AlexMacQuarrie/yachtonomous/README.md

# yachtonomous
Autonomous Sailboat Project

Yachtonomous is an Autonomous Sailboat project created for ELEC 490 Capstone Project, 2024-2025

Authors (Group 32):
- Alex MacQuarrie
- Liam Herbert
- Yasin Shahrami

Faculty Supervisor:
- Dr. Sean Whitehall

## Structure
- boat - Boat model (3D models)
- hardware - Electronics (PCBs)
- src - Source code for the boat (Python, MicroPython, C++)
- sim - Simulation code for the boat (Python)
- docs - Project documentation (Text files for mermaid charts)
- firmware - Raspberry Pi Pico W Firmware (MicroPython & ulab)
