AlexMacQuarrie/yachtonomous/hardware/README.md

# Hardware
This directory stores electronics-related files like PCB and circuit files
