AlexMacQuarrie/yachtonomous/firmware/README.md

# Firmware
This directory stores the .uf2 firmware for the Pico W
