AlexMacQuarrie/yachtonomous/poster.pdf

#32

Group Number

# Yachtonomous – An Autonomous Sailboat

Group Members: Liam Herbert, Alex MacQuarrie. Yasin Shahrami

PERFORMANCE & RESULTS
Individual | testing | was | completed | for | each
subsystem before integration. All PCBs are fully functional and fit in the boat. After calibration, the sensors and actuators were tested and proved to be reasonably accurate. The software was fast enough to complete a control loop iteration in 30 milliseconds.

An inflatable test pool was used to test the boat’s sailing ability in a variety of wind directions, with Bluetooth range sensors attached to the sides.

The boat struggled to sail in a straight line in most wind directions, but had some success sailing on beam reaches and broad reaches. The boat did not float as well as anticipated due to the weight of electronics, so external floatation was added.

CONCLUSIONS & RECOMMENDATIONS Overall, the design and functionality of the boat was reasonably successful. While the boat struggled to sail in some directions, it was able to sail to the destination in others, demonstrating the overall feasibility of autonomous sailboats.

The main challenge was making a boat and sail that were aerodynamically functional. The boat could be further improved by modelling the boat’s dynamics better, improving the boat and sail’s aerodynamics, using servos with rotational encoders, and using I2C for the rotation sensors instead of PWM.

ACKNOWLEDGEMENTS
We would like to thank the following people for their assistance and support in helping us undertake this project:
- Dr. Sean Whitehall, for his support in supervising the project
- Dr. Joshua Marshall, for his teaching and resources provided in ELEC 446 - Mobile Robotics
- Vince Lentini, for this support and guidance in 3D printing the boat and soldering PCBs

REFERENCES

[1] R. Wintour, "Replacing container ships with sailing boats: the future of cargo shipping?" The Guardian, Jul. 14, 2022. [Online]. Available: https://www.theguardian.com/world/2022/jul/14/replacing-container-ships-with-sailingboats-cargo-shipping-wind-power.
[2] L. Eale, "Livo 3," Thingiverse, 2015. [Online]. Available: https://www.thingiverse.com/thing:918471.
[3] Seeed Technology Co., Ltd., "Getting Started with Seeed Studio XIAO ESP32C3“, Aug. 4, 2022. [Online]. Available: https://fcc.report/FCC-ID/z4t-xiaoesp32c3/6038995.pdf.
[4] J. A. Marshall, Fundamentals of Autonomous Ground Vehicle Navigation & Control with Examples in Python, v0.5.5. Kingston, Ontario, Canada, Oct. 11, 2024.

INTRODUCTION
Sailboats provide an environmentally-friendly and
energy | efficient | alternative | for | aquatic
transportation [1]. An autonomous sailboat presents a novel design challenge and provides further benefits by eliminating manual operation.

This project aims to demonstrate the feasibility of autonomous sailing vehicles on a reduced scope, focusing on the development of methods for navigation, localization, and control of autonomous sailboats, using onboard sensors and actuators, power, and wireless communications.

BOAT DESIGN
The boat uses a trimaran design to increase stability and area for electronics [2]. 3D printing reduced cost and provided more control over the design.

The mast is driven by a belt attached to a servo, and the rudders are driven by another servo attached with a linkage system. The mainsail is made of nylon and given a shape suitable to act as an air foil to provide propulsion.

ELECTRONICS
The boat uses an IMU, two rotation sensors, and
several | Bluetooth | range | sensors | with | RSSI
measurements for localization. For actuation, two servo motors control the mast and rudder motion.

PCBs house and connect the MCUs, sensors, actuators, and power management, all powered by a 3.7V lithium-ion battery. Communication is achieved using I2C, PWM, Wi-Fi, and Bluetooth to send data between sensors, actuators, and controllers [3].

SOFTWARE
The | boat’s | software | is | written | in | Python,
MicroPython, and C++. The onboard Raspberry Pi reads from sensors, sends the sensor data over Wi-Fi to a PC, which runs navigation, localization, and control algorithms, to compute actuator inputs.

The custom navigation algorithm allows the boat to sail in any wind direction, while minimizing distance and number of tacks. Localization and feedback control are implemented using an Extended Kalman Filter, and Model Predictive Control, respectively [4].

A software simulation environment was also completed to allow for testing and development, independent of the hardware.

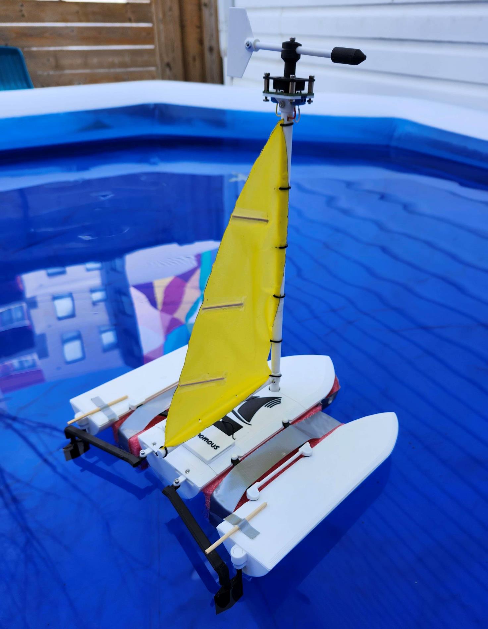
[picture p1: figure]

(1) The boat in the test environment

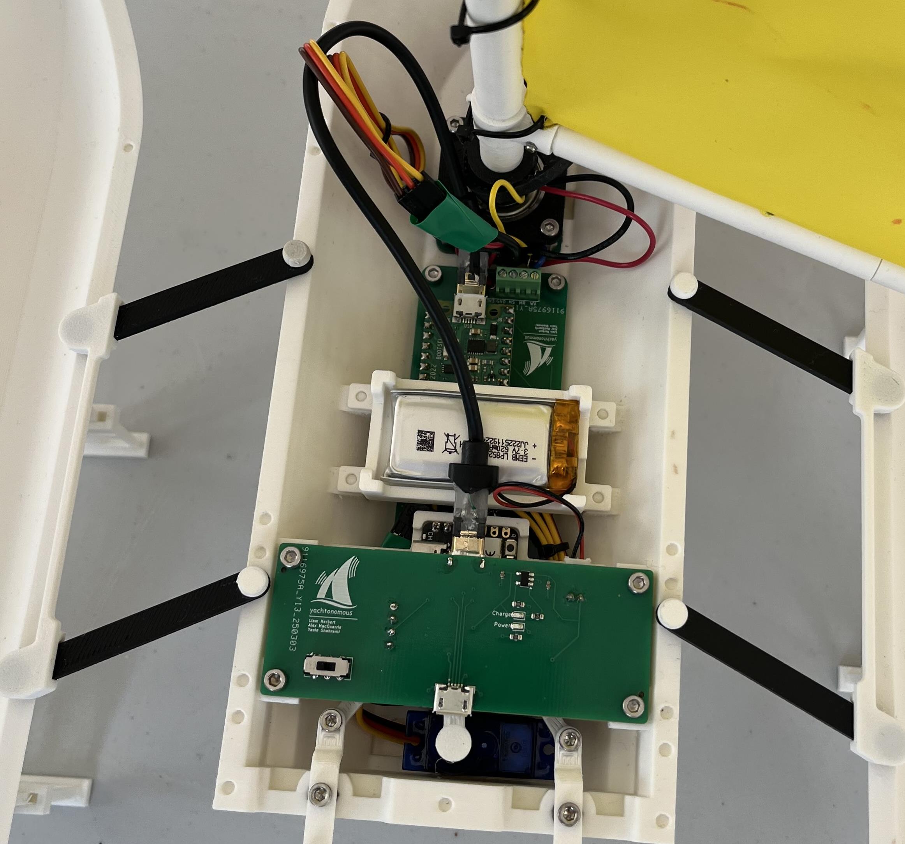
[picture p2: figure]

(2) Electronics inside the main hull

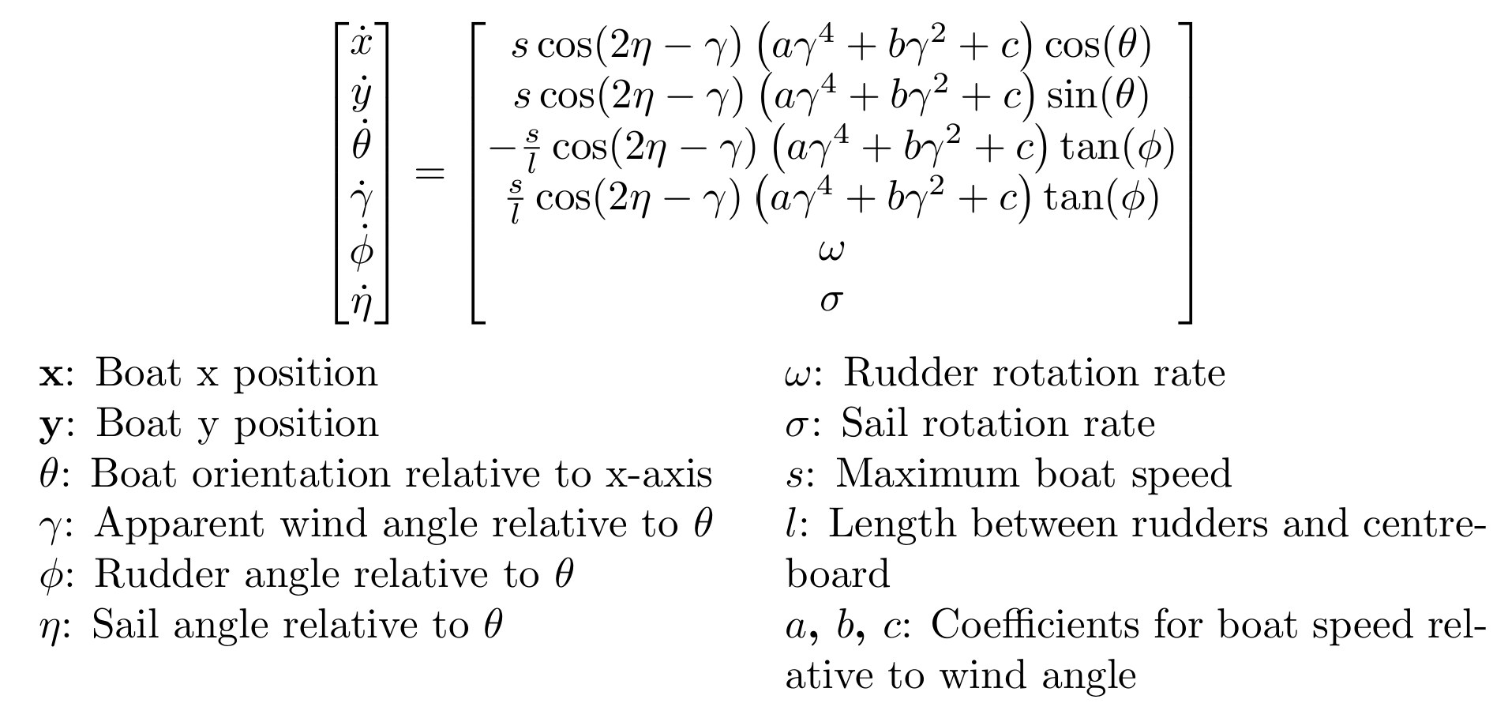
[picture p3: figure]
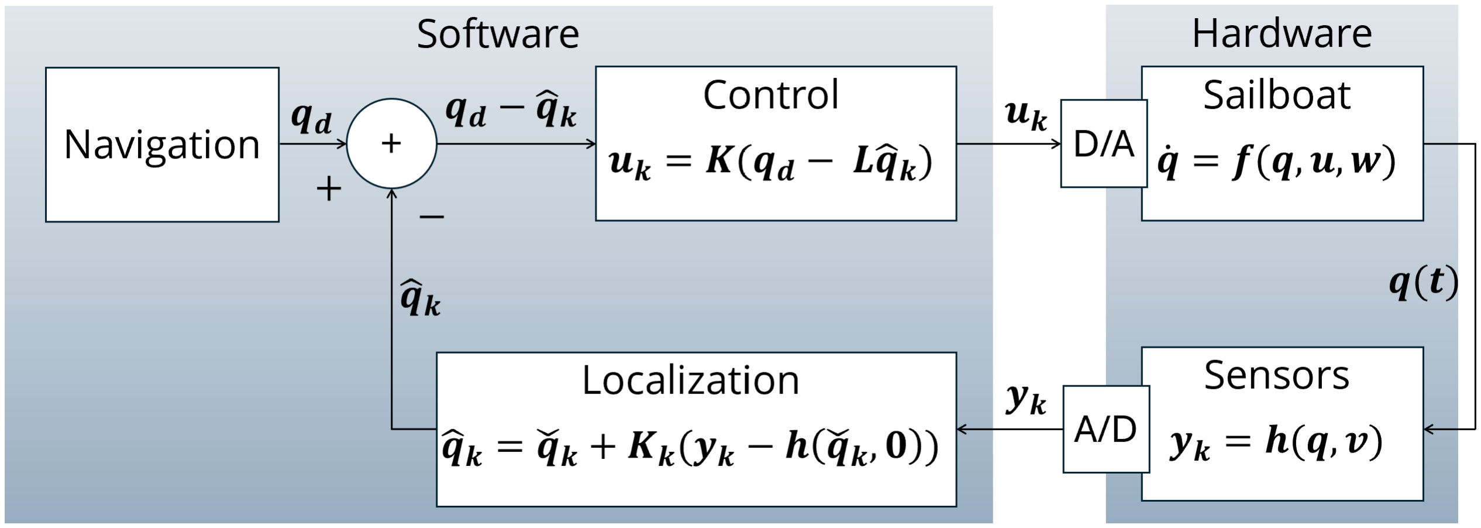
[picture p4: figure]

(3) Control block diagram | (4) Kinematic model of the boat’s motion

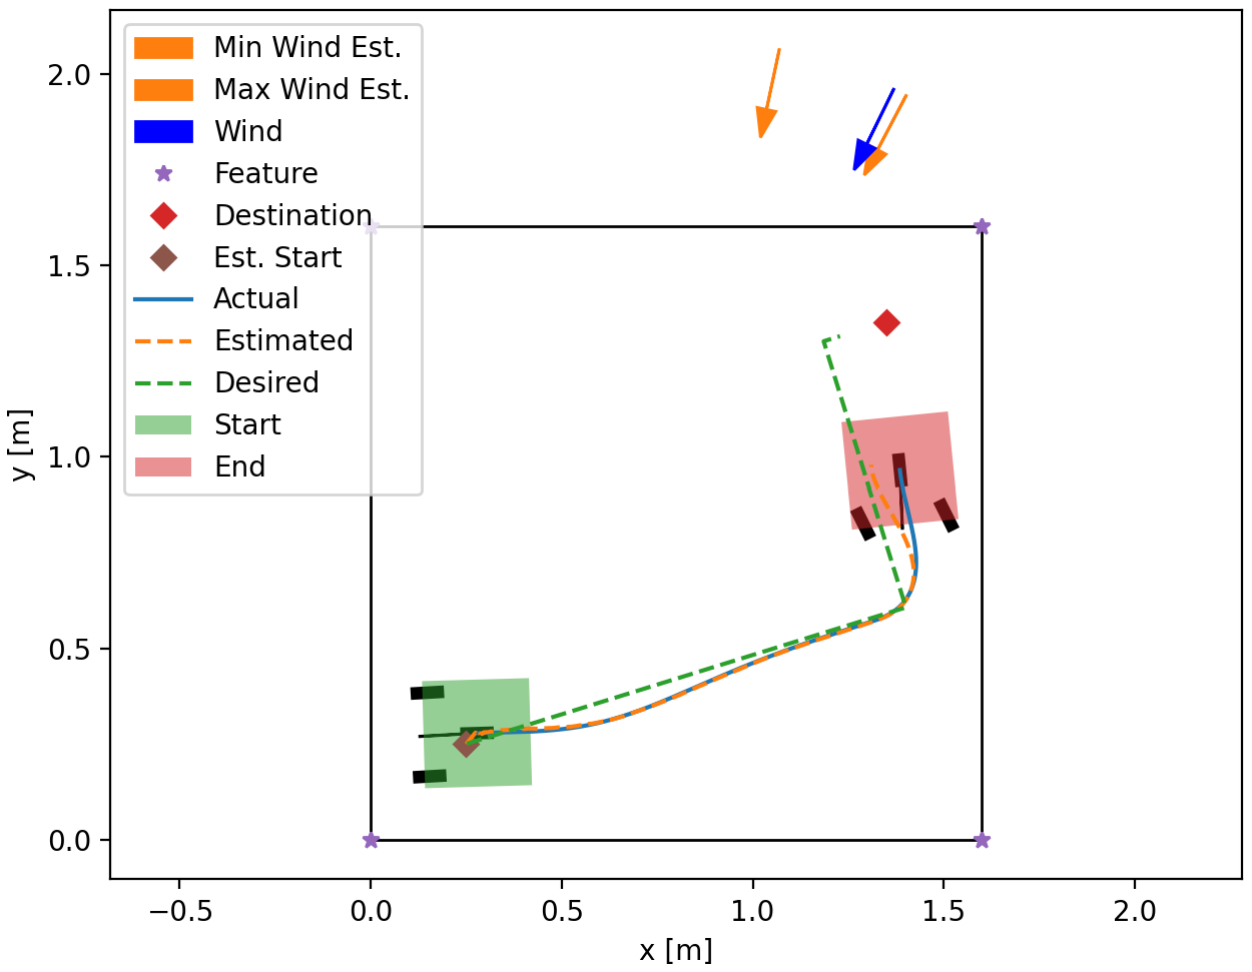
[picture p5: figure]
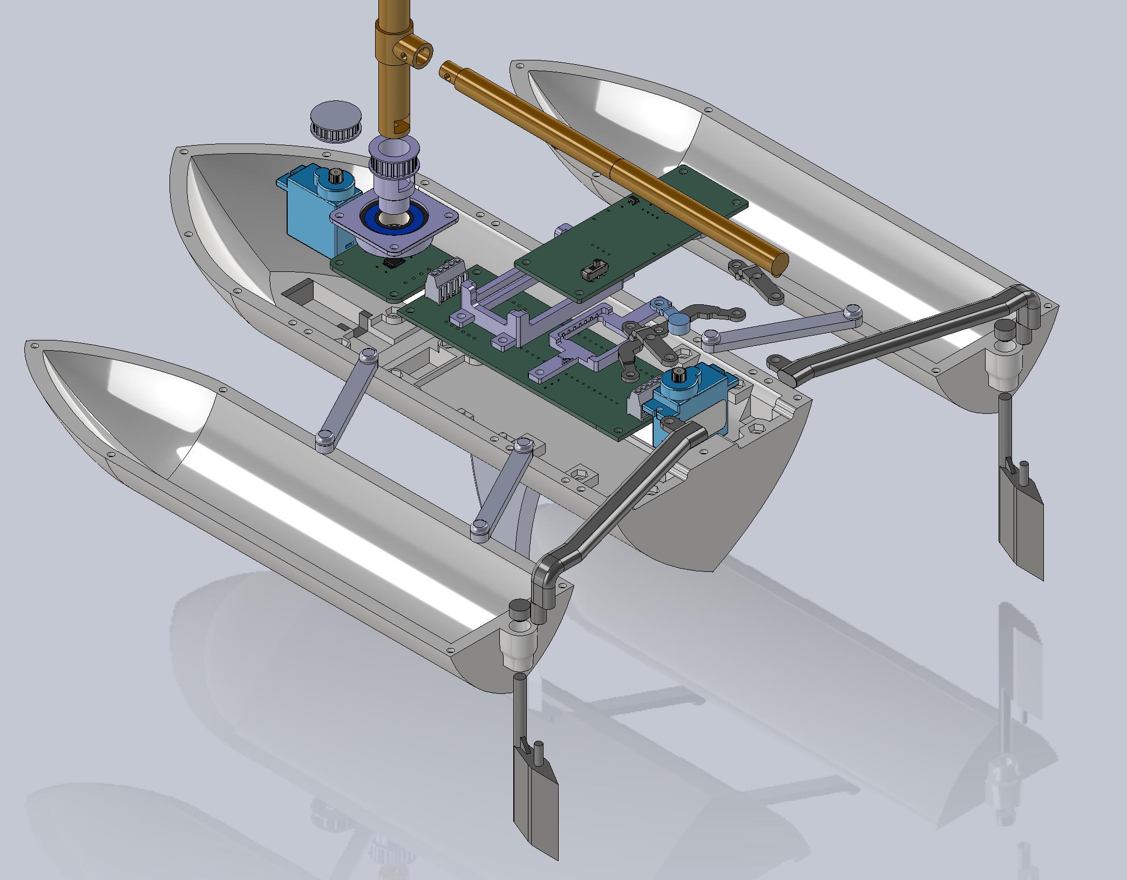
[picture p6: figure]

(5) SOLIDWORKS exploded assembly view | (6) An output from the software simulation

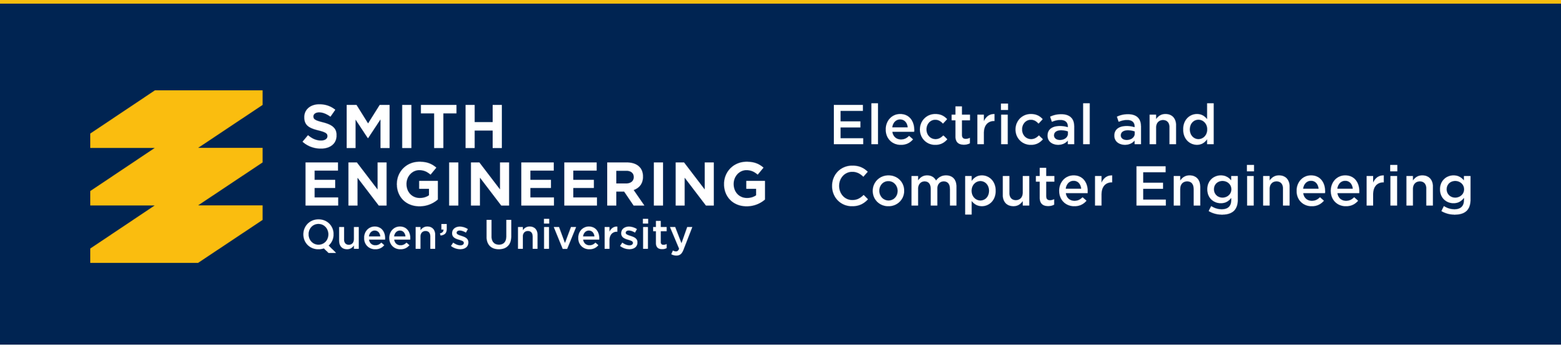
[picture p7: figure]
