AlexMacQuarrie/yachtonomous/src/results/boat_log.csv

x_x | x_y | x_t | x_g | x_p | x_e | x_d_x | x_d_y | x_d_t | x_d_g | x_d_p | x_d_e | u_e | u_p | u_a_e | u_a_p | t
0.35 | 0.35 | 0.0 | 0.5 | 0.0 | 0.0 | 0.35226819349951377 | 0.349334493897513 | -0.2853981633974483 | 0.7853981633974483 | 0.0 | 0.39269908169872414 | 0.0 | 0.0 | 0.0 | 0.0 | 0.0
238.5351666156384 | -130.85159986987676 | 0.020256670128192815 | 0.49903870224994484 | -0.005485558678632211 | 0.5011227063979126 | 0.35453638699902756 | 0.348668987795026 | -0.2853981633974483 | 0.7853981633974483 | 0.0 | 0.39269908169872414 | -0.09003264965771073 | -0.7853981633974483 | -0.0045016324828855364 | -0.039269908169872414 | 0.05
238.53715562469958 | -130.85153186418245 | 0.032993233563017074 | 0.49925580973211486 | -0.061491023765534655 | 0.4982982879787614 | 0.35680458049854136 | 0.348003481692539 | -0.2853981633974483 | 0.7853981633974483 | 0.0 | 0.39269908169872414 | -0.08768731325410199 | -0.7853981633974483 | -0.008885998145590636 | -0.07853981633974483 | 0.1
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
