AlexMacQuarrie/yachtonomous/(commit log)

2025-02-08 Added integration for imu & inputs. Sim (kinematic) should be done now
2025-02-13 Updates for switching to Wifi and computation on PC
    [boat_log.csv]
2025-02-13 Adding firmware and changing parse_csv.py a bit
    [boat_log.csv]
2025-02-14 making stuff a bit faster, still working on that
    [boat_log.csv]
2025-02-15 some more performance improvements, done for now
    [boat_log.csv]
2025-02-23 Adding some initial RSSI handling and ESP32 server/client code
2025-02-27 Adding wifi code
    [boat_log.csv]
2025-02-28 Updating ESP32 delays, needs to be tested
2025-02-28 Adding zip file for PCB files
2025-02-28 Fix ESP32 string type
    [esp32_cli_0.ino, esp32_cli_1.ino, esp32_cli_2.ino, esp32_cli_3.ino]
2025-03-01 adding initial driver files
2025-03-01 updating esp32 comms
    [boat_log.csv]
2025-03-02 adding servo and rotation sensor drivers
2025-03-02 couple small changes
2025-03-03 servo refactor
2025-03-03 calibrating rssi parms & noise
    [sensor.py]
2025-03-03 adding measured rotation sensor noise
    [rotation.py]
2025-03-06 adding imu driver
2025-03-10 better results formatting and adding new callflow
    [boat_log.csv]
2025-03-25 adding zip files for solidworks and pcbs
